ramonlh/Raduino32/doc/Bottom Layer.PNG

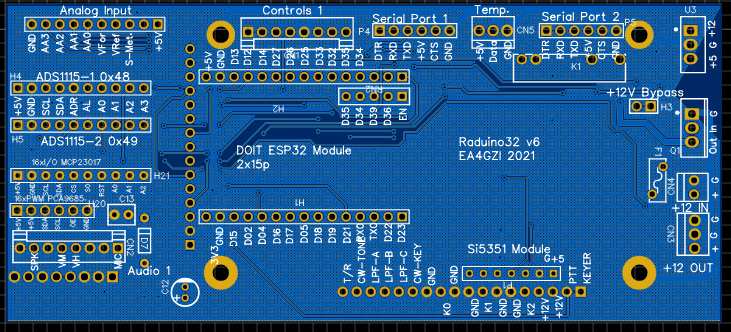
doc/Bottom Layer.PNG
