ramonlh/Raduino32/doc/Si5351module.jpg

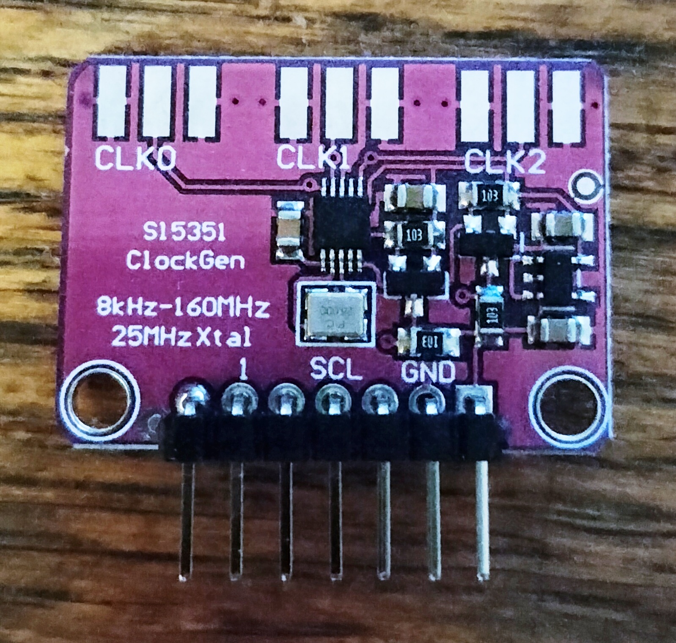
doc/Si5351module.jpg
