ramonlh/Raduino32/README.md

# Raduino32
Raduino with ESP32 for uBitx 

A Raduino board with ESP32 for uBitx radio.
