ramonlh/Raduino32/doc/Schematic_Raduino32 v6 (en fabrica)_2021-09-27.pdf

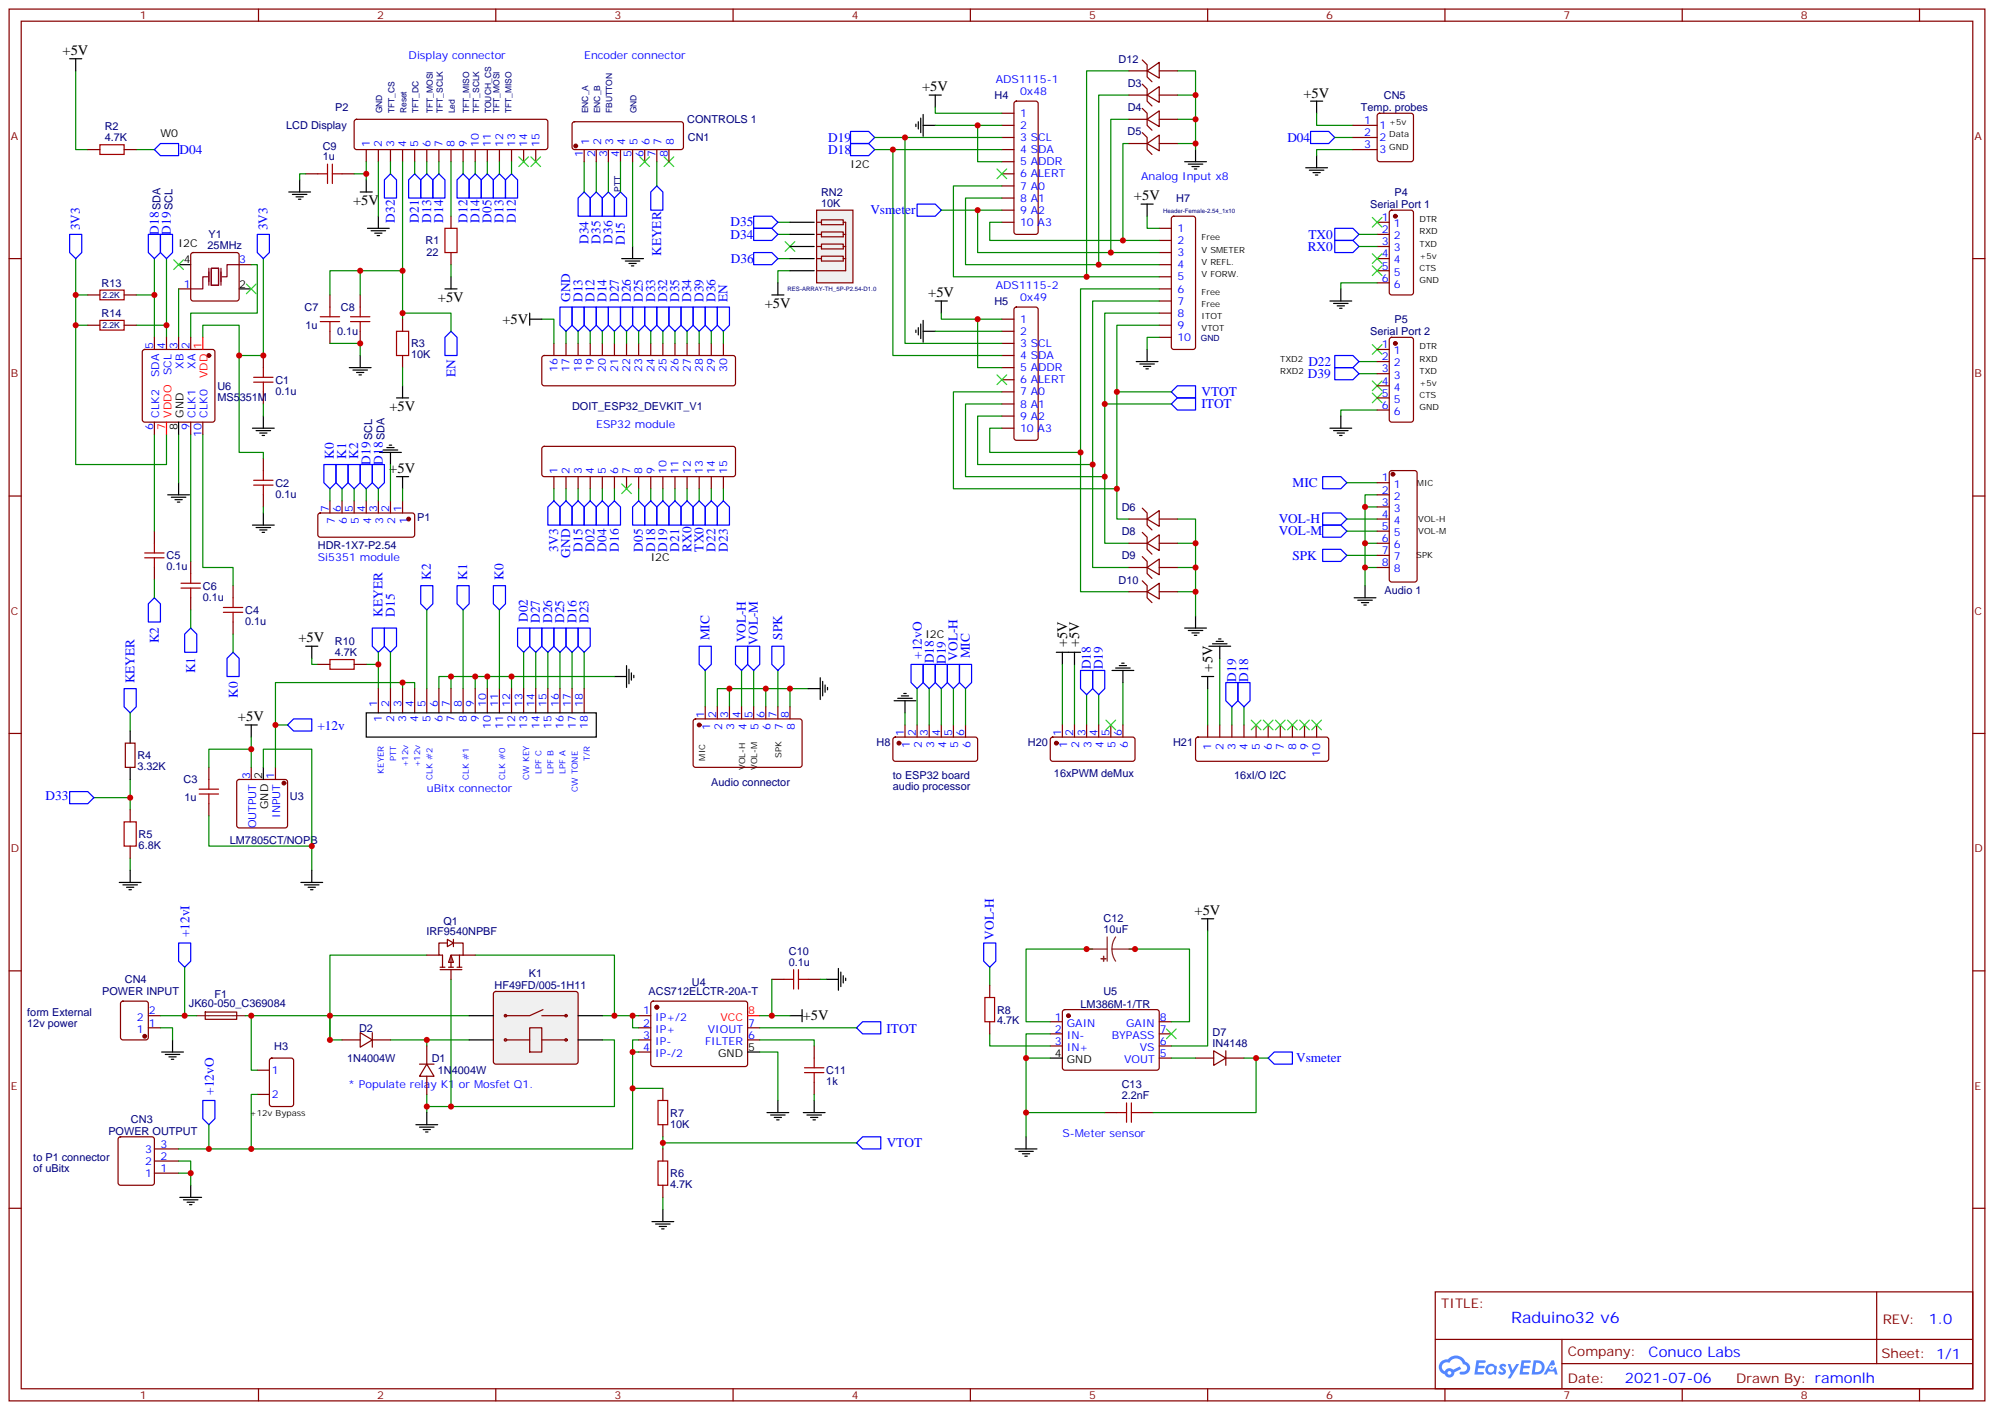
[picture p41: page 1]

* Populate relay K1 or Mosfet Q1.
