ramonlh/Raduino32/doc/Schematic_Raduino32 v6.2 con ADS1115_2022-02-13.pdf

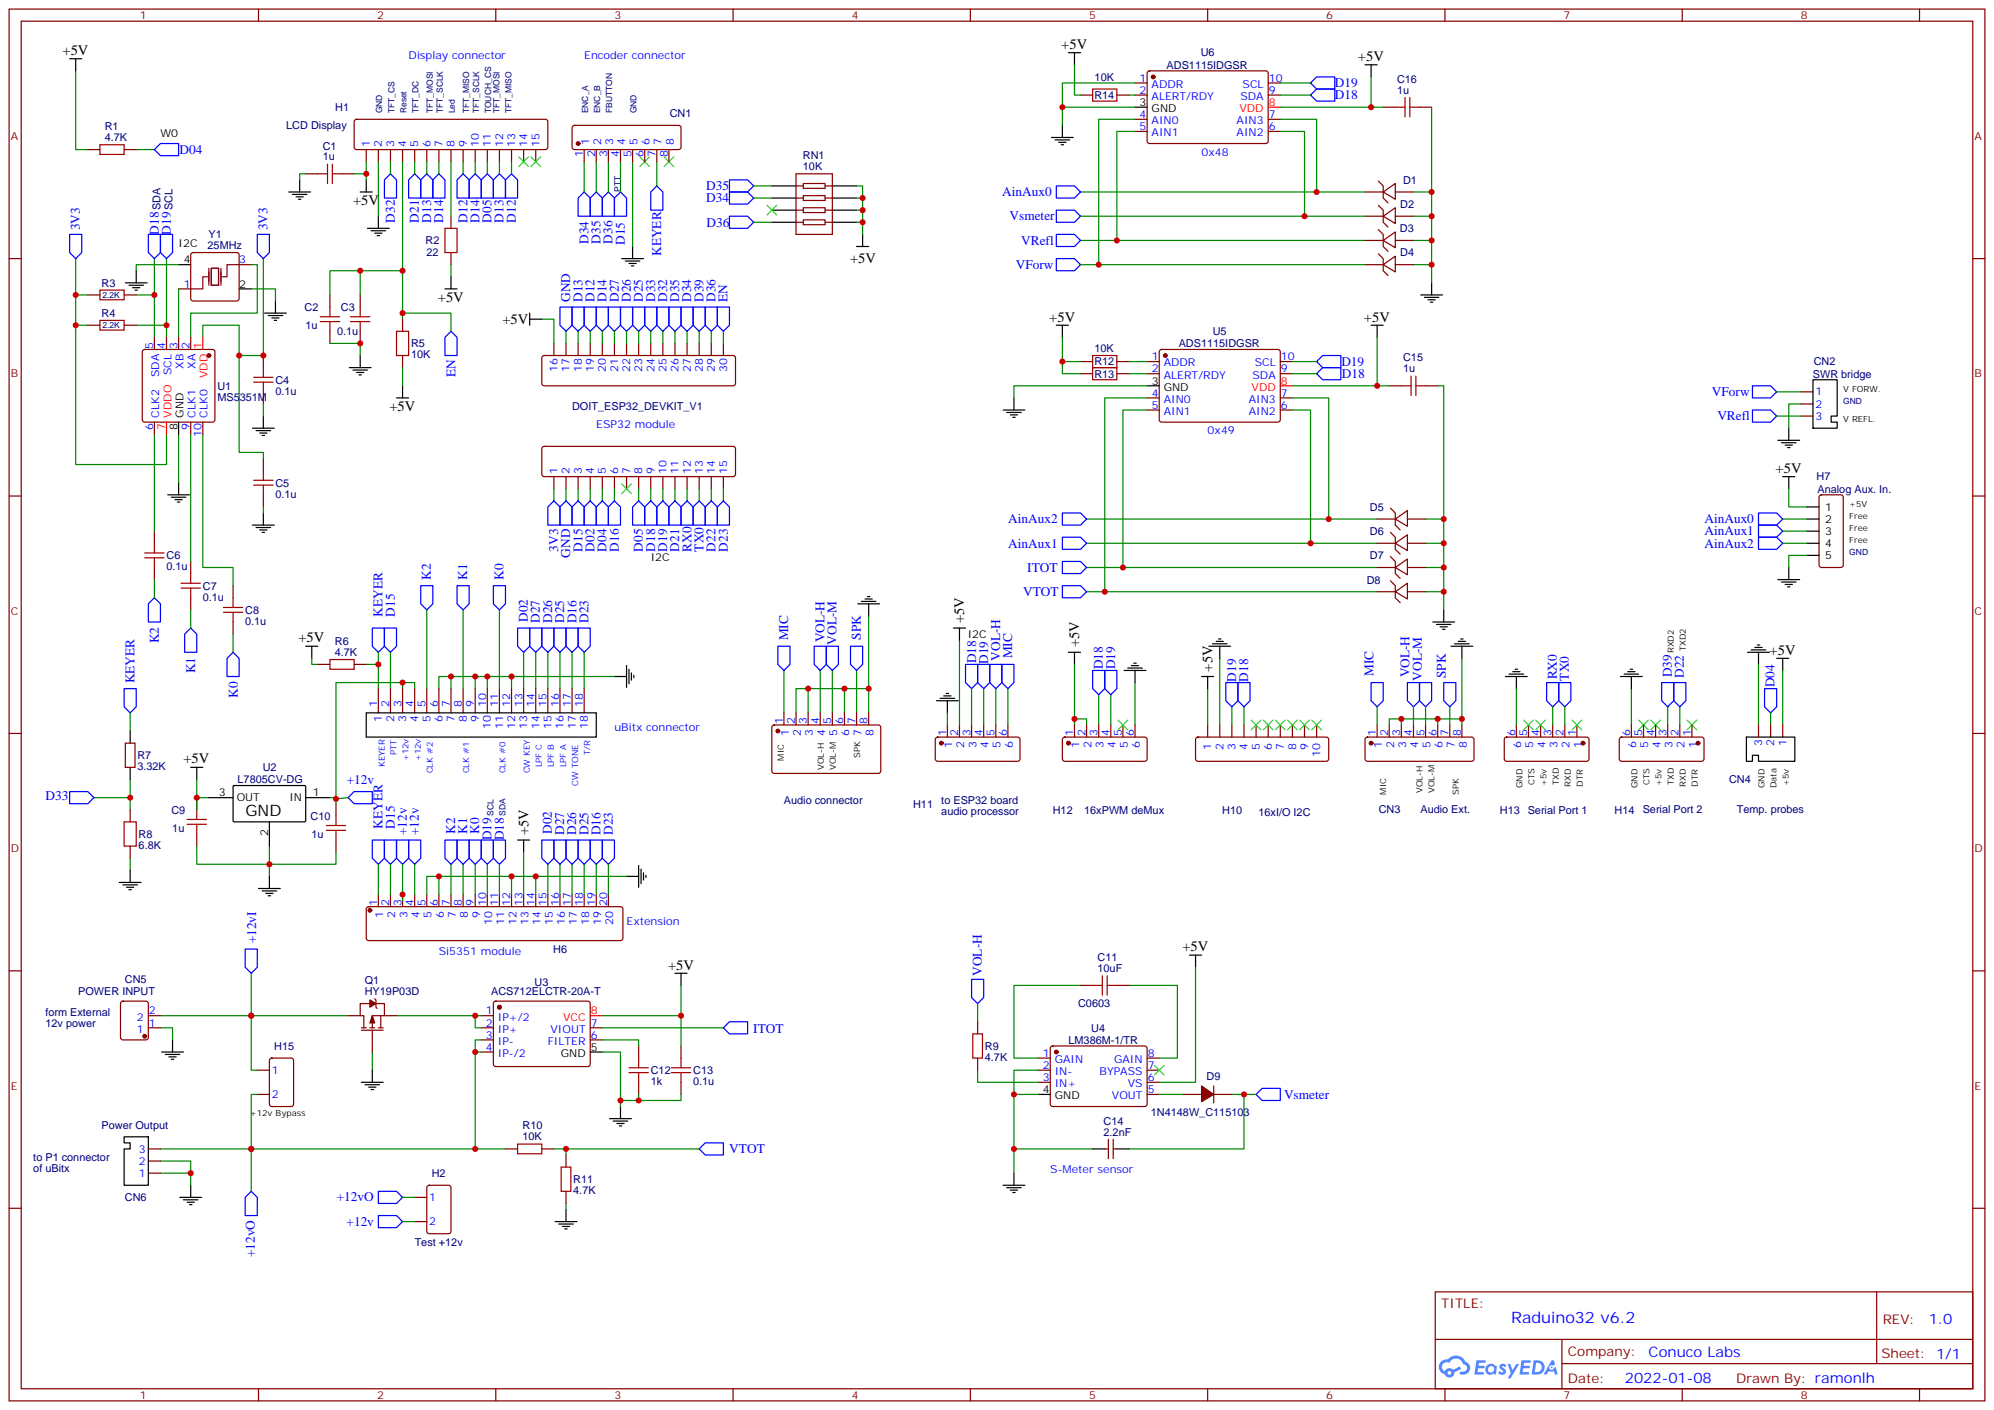
[picture p42: page 1]
