ramonlh/Raduino32/doc/Schematic_Raduino32 v6.1_2022-02-13.pdf

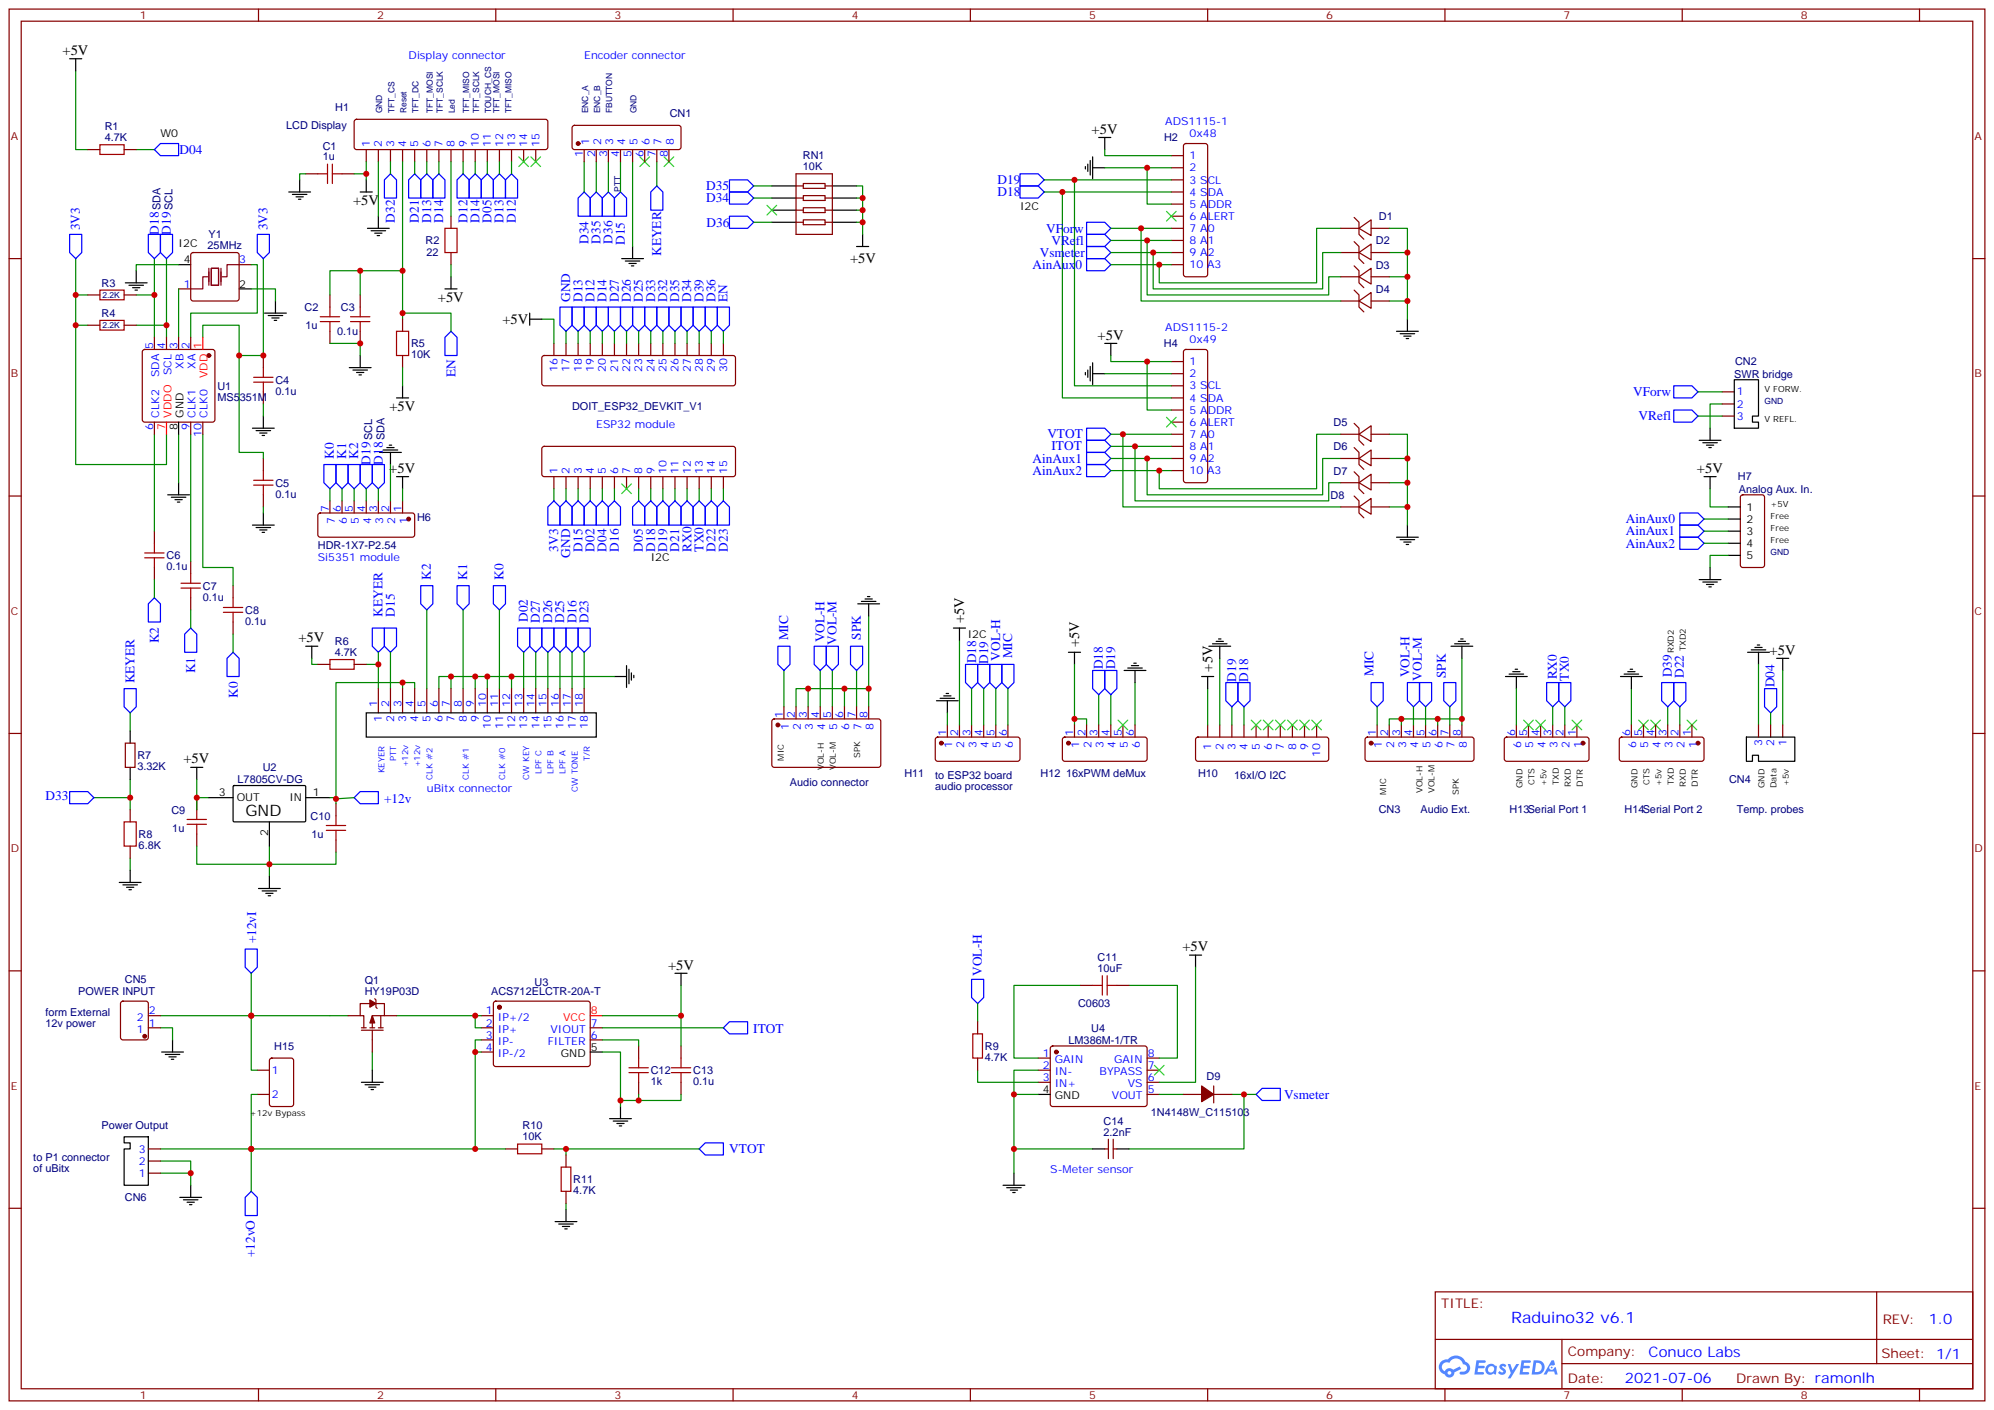
[picture p43: page 1]
