ramonlh/Raduino32/Multidevice/UuBitx02.cpp

// ---------------------------------------------------------------------------

#include <fmx.h>
#pragma hdrstop

#include "UuBitx02.h"
// ---------------------------------------------------------------------------
#pragma package(smart_init)
#pragma resource "*.fmx"
TFrame2 *Frame2;

// ---------------------------------------------------------------------------
__fastcall TFrame2::TFrame2(TComponent* Owner) : TFrame(Owner) {
}
// ---------------------------------------------------------------------------
