ramonlh/Raduino32/Multidevice/UuBitx03.cpp

//---------------------------------------------------------------------------

#include <fmx.h>
#pragma hdrstop

#include "UuBitx03.h"
//---------------------------------------------------------------------------
#pragma package(smart_init)
#pragma resource "*.fmx"
TF3 *F3;
//---------------------------------------------------------------------------
__fastcall TF3::TF3(TComponent* Owner)
	: TForm(Owner)
{
}
//---------------------------------------------------------------------------
